dsterni/WaterRocket-Flight-Logger/case/case_v2.stl

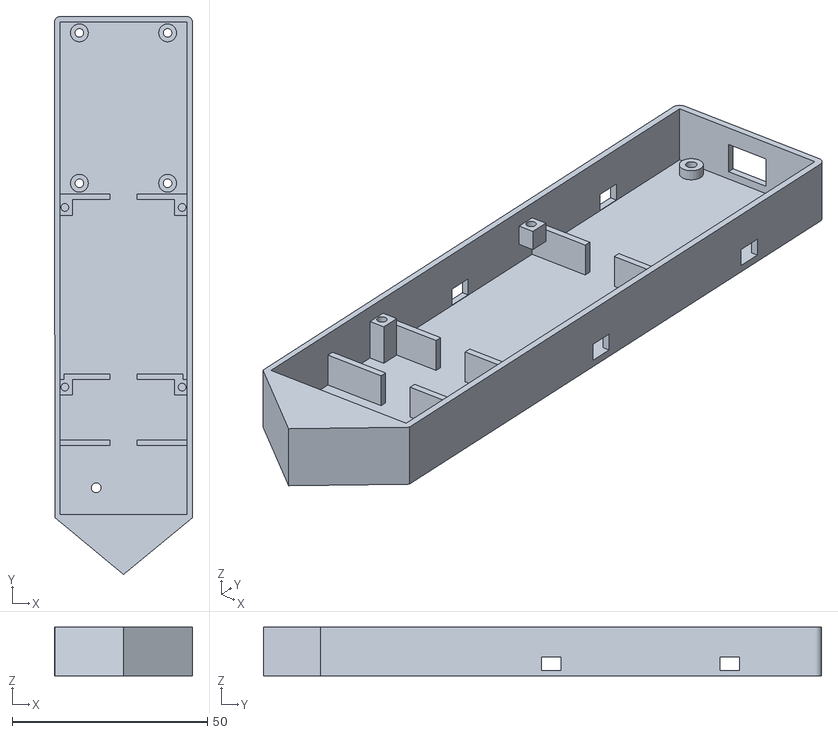
[picture p4: CAD file, 2026-09-29]
case/case_v2.stl
35.4 x 142.9 x 12.5
