dsterni/WaterRocket-Flight-Logger/case/rocket_case.step

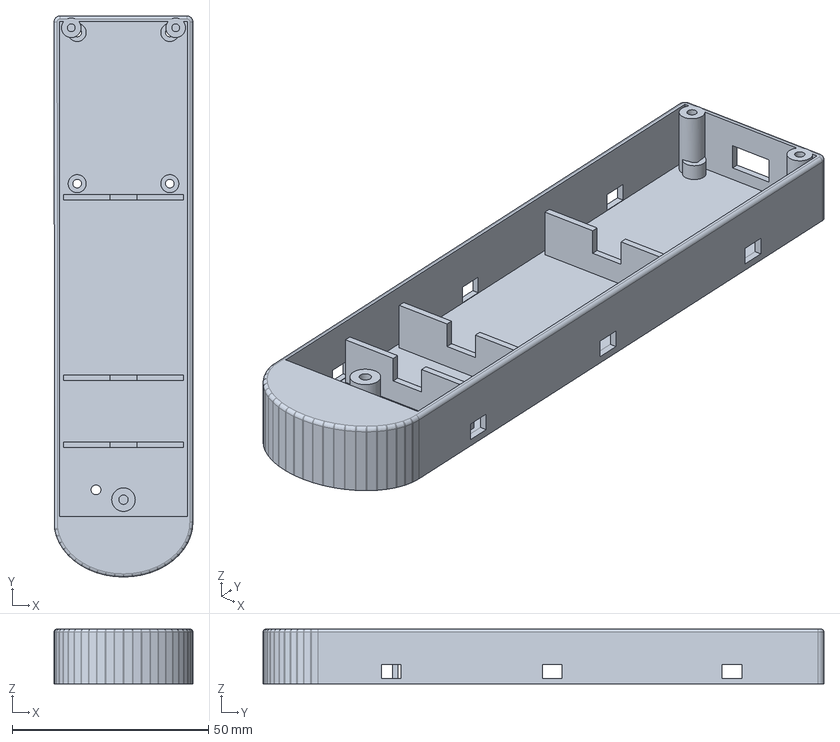
[picture p5: CAD file, 2026-09-29]
case/rocket_case.step
35.4 x 142.9 x 14.0 mm
