dsterni/WaterRocket-Flight-Logger/case/Case.3mf

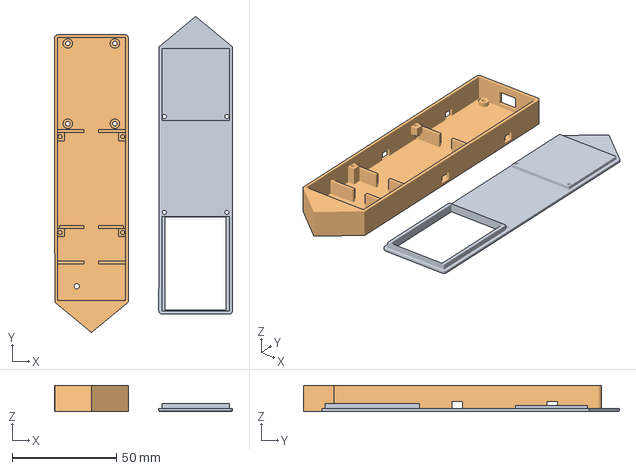
[picture p6: CAD file, 2026-09-29]
case/Case.3mf
85.4 x 151.7 x 12.5 mm
decleö.stl
case_v2.stl
