dsterni/WaterRocket-Flight-Logger/case/rocket_tracker.step

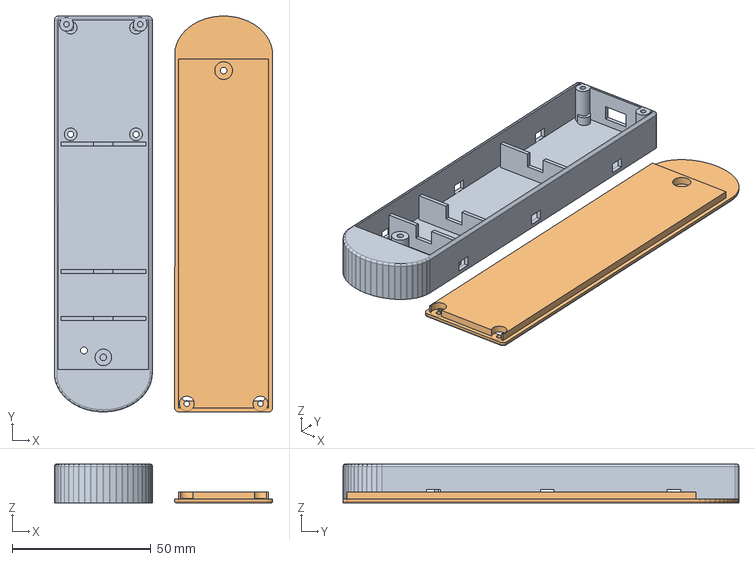
[picture p7: CAD file, 2026-09-29]
case/rocket_tracker.step
78.8 x 142.9 x 14.0 mm
