dsterni/WaterRocket-Flight-Logger/case/top.stl

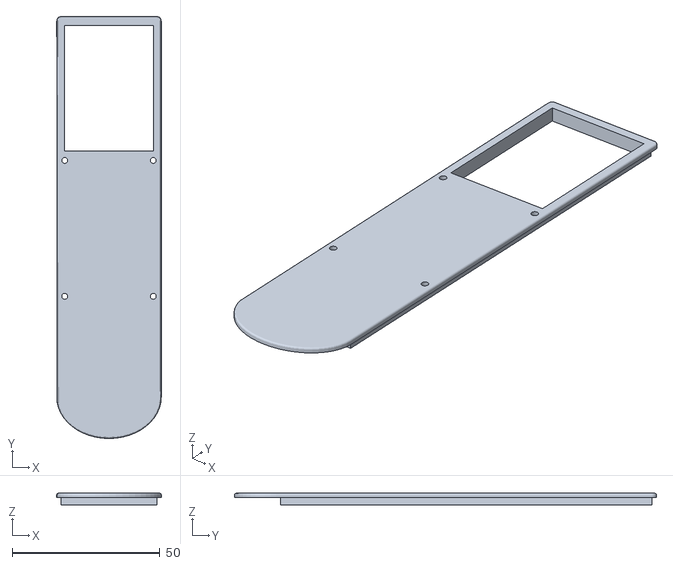
[picture p8: CAD file, 2026-09-29]
case/top.stl
35.4 x 142.9 x 3.90
