dsterni/WaterRocket-Flight-Logger/case/deckel.stl

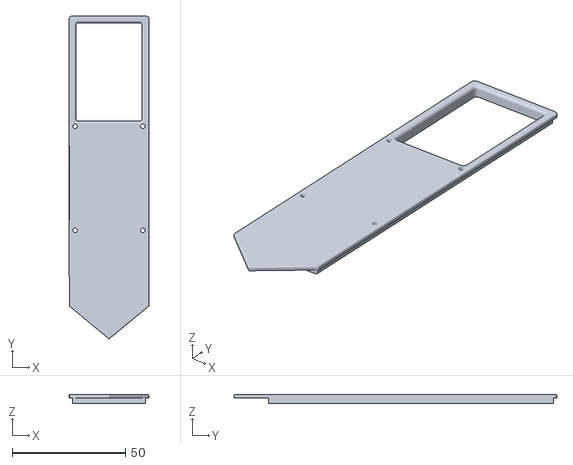
[picture p9: CAD file, 2026-09-29]
case/deckel.stl
35.4 x 142.7 x 3.90
