dsterni/WaterRocket-Flight-Logger/case/decke.stl

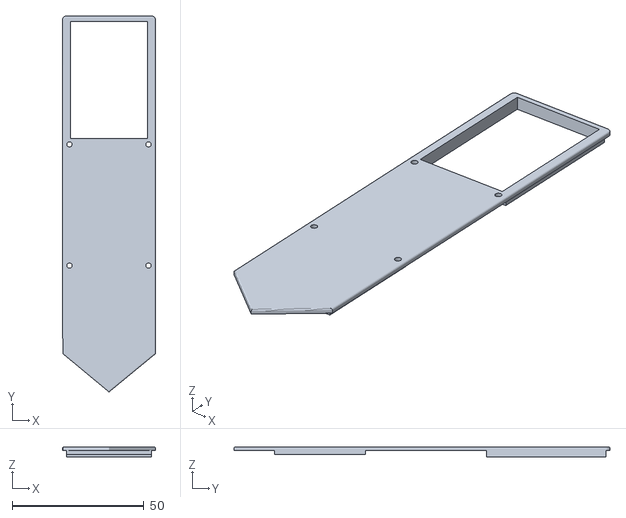
[picture p10: CAD file, 2026-09-29]
case/decke.stl
35.4 x 142.7 x 3.90
