dsterni/WaterRocket-Flight-Logger/case/Gehäuse.stl

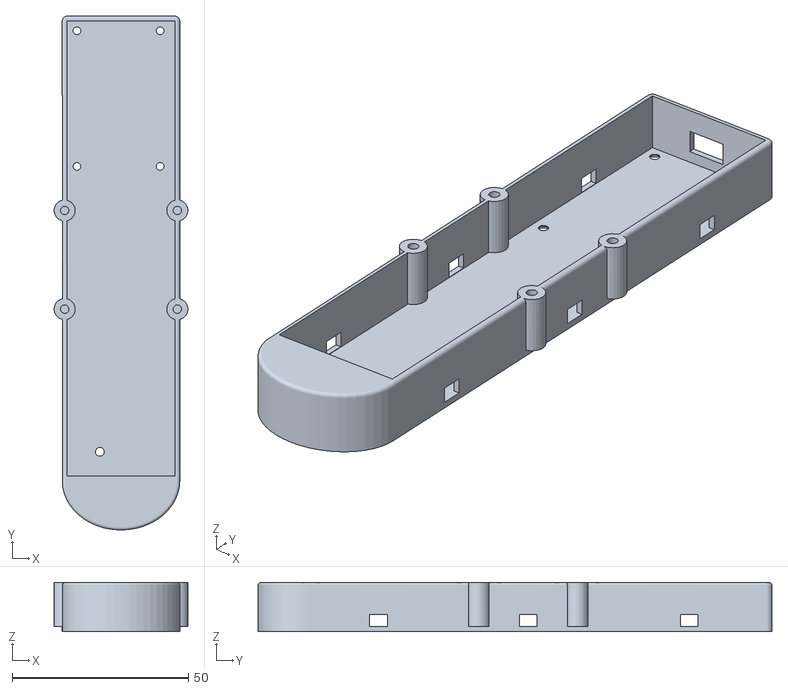
[picture p11: CAD file, 2026-09-29]
case/Gehäuse.stl
38.0 x 145.9 x 14.0
