dsterni/WaterRocket-Flight-Logger/(list of files, cad)

Other CAD files:
case/Case.stl
